StephS/6-Pack_CNC_Controller/images/iot_relay.png

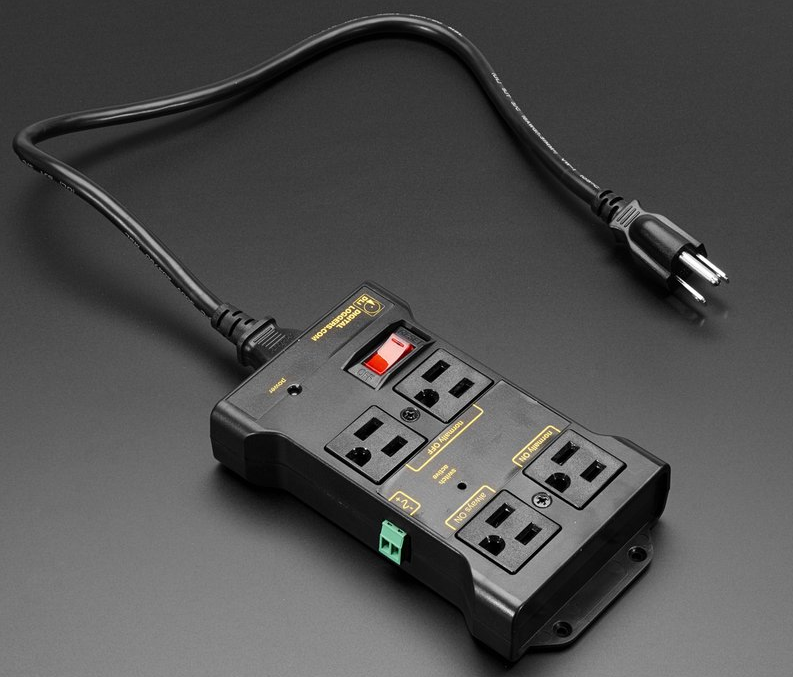
images/iot_relay.png
