StephS/6-Pack_CNC_Controller/versions/V1p8s/6_axis_I2S_v1p8s_Bottom.jpg

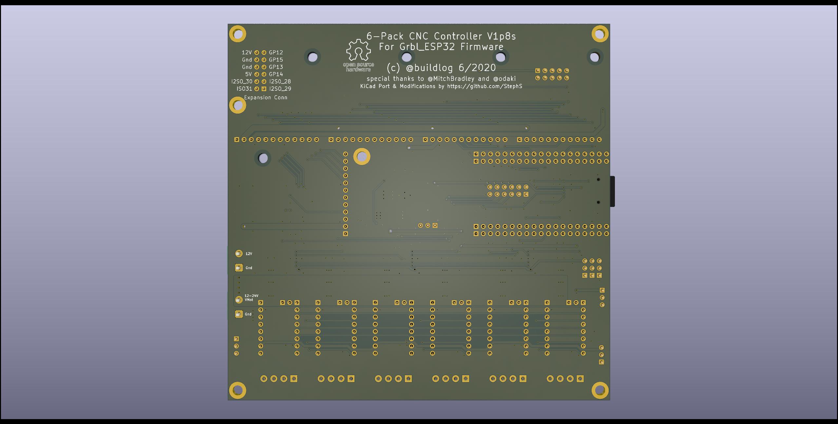
versions/V1p8s/6_axis_I2S_v1p8s_Bottom.jpg
