StephS/6-Pack_CNC_Controller/3D_Files/4x_support.stp

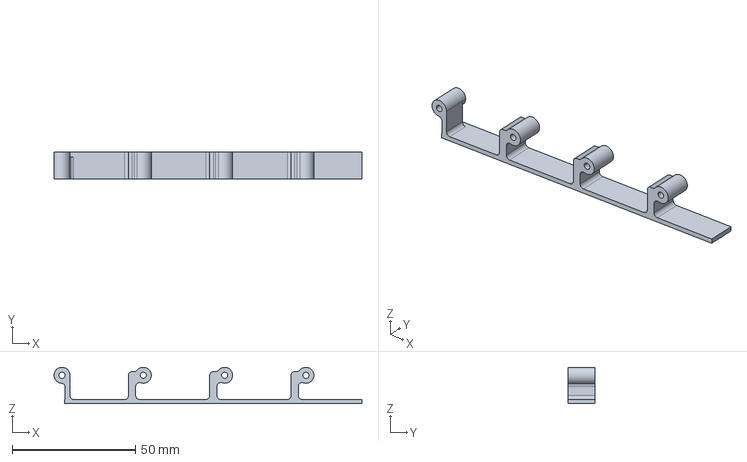
[picture p4: CAD file, 2022-01-27]
3D_Files/4x_support.stp
125.1 x 11.0 x 14.8 mm
