StephS/6-Pack_CNC_Controller/3D_Files/case/6_pack_cover_top.stp

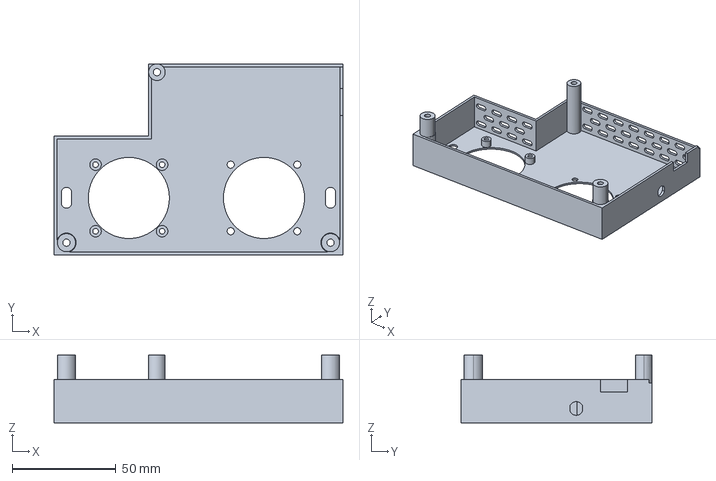
[picture p5: CAD file, 2022-01-27]
3D_Files/case/6_pack_cover_top.stp
139.0 x 92.0 x 32.7 mm
