StephS/6-Pack_CNC_Controller/3D_Files/1x_supp.stp

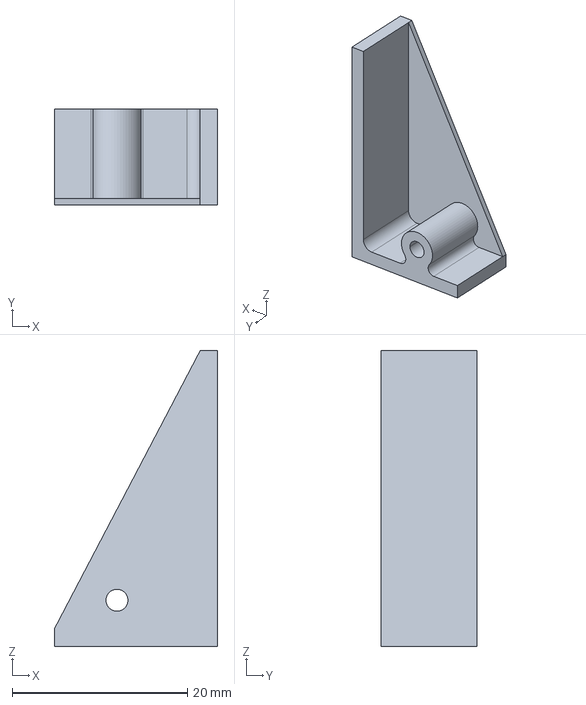
[picture p6: CAD file, 2022-01-27]
3D_Files/1x_supp.stp
18.7 x 11.0 x 33.8 mm
