StephS/6-Pack_CNC_Controller/3D_Files/case/6_pack_case_bottom.stp

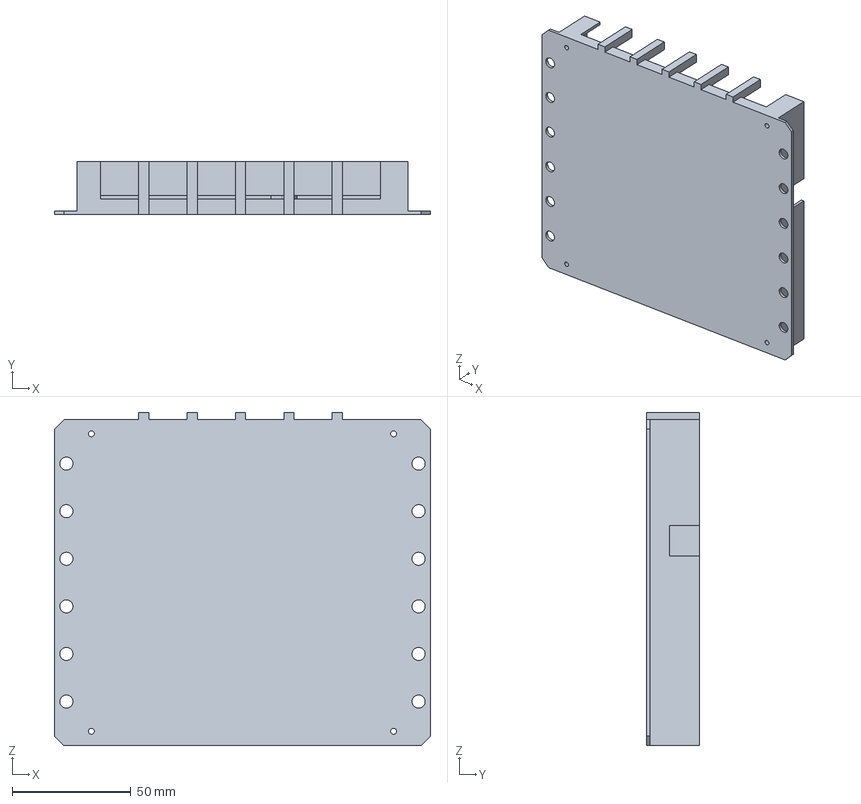
[picture p7: CAD file, 2022-01-27]
3D_Files/case/6_pack_case_bottom.stp
158.0 x 22.2 x 140.0 mm
