StephS/6-Pack_CNC_Controller/(list of files, cad)

Other CAD files:
3D_Files/1x_supp.stl
3D_Files/4x_support.stl
3D_Files/case/6_pack_case_bottom.stl
3D_Files/case/6_pack_cover_top.stl
