StephS/6-Pack_CNC_Controller/versions/V1p8s/6_axis_I2S_v1p8s.pdf

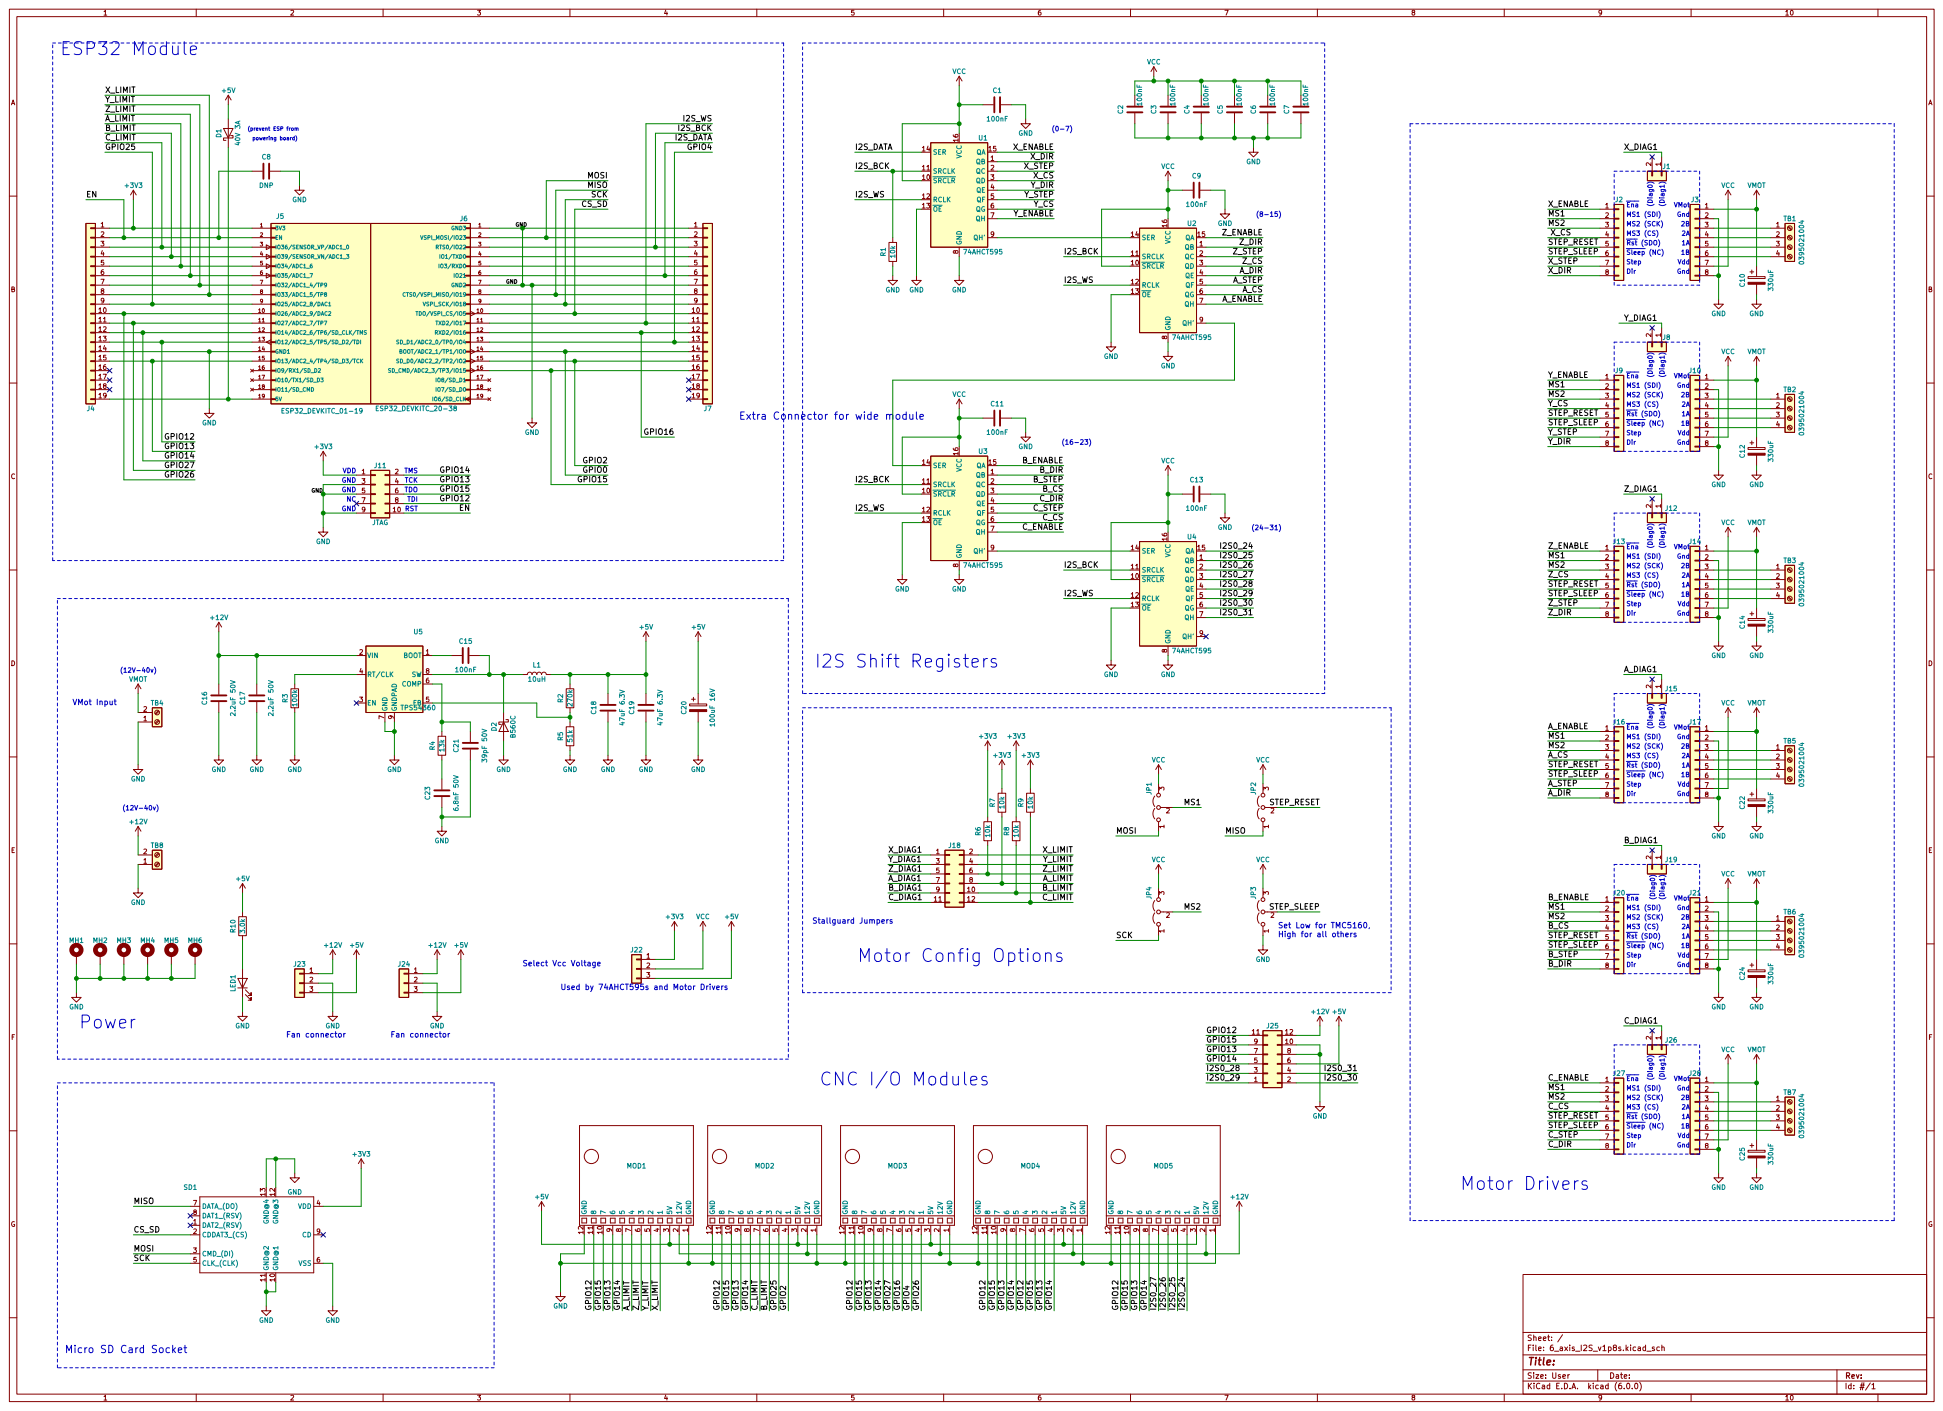
[picture p8: page 1]

Extra Connector for wide module

Micro SD Card Socket
