StephS/6-Pack_CNC_Controller/versions/V1p8s/6_axis_I2S_v1p8s.kicad_pcb

## KiCad design versions/V1p8s/6_axis_I2S_v1p8s.kicad_pcb (2021-12-27)

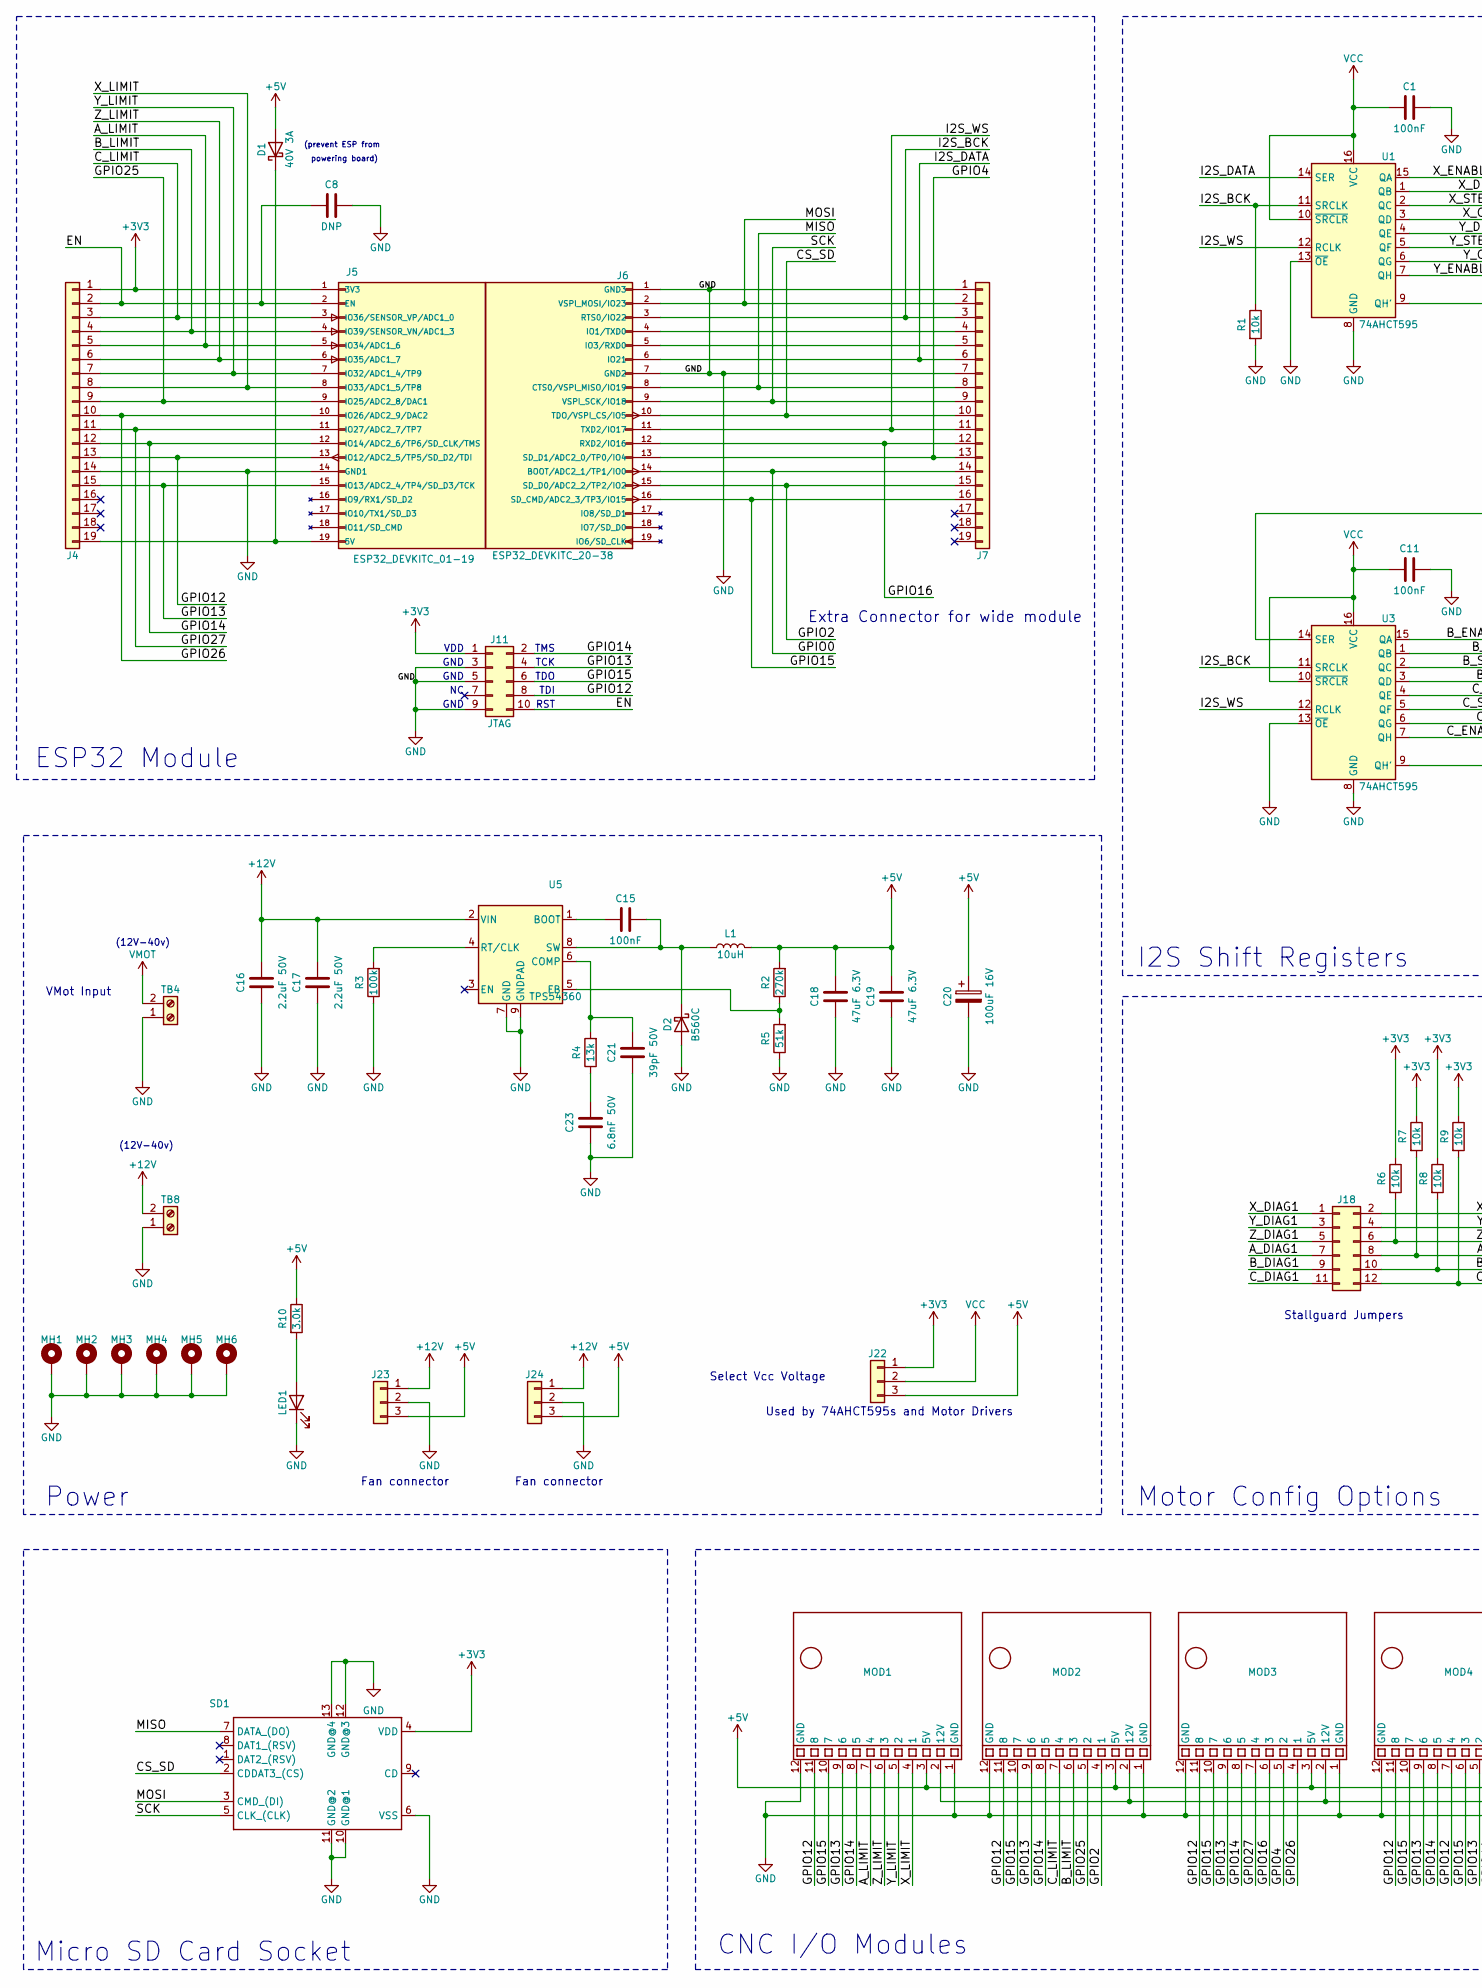
[picture p9: schematic 6_axis_I2S_v1p8s.kicad_sch, part in row 1, column 1]

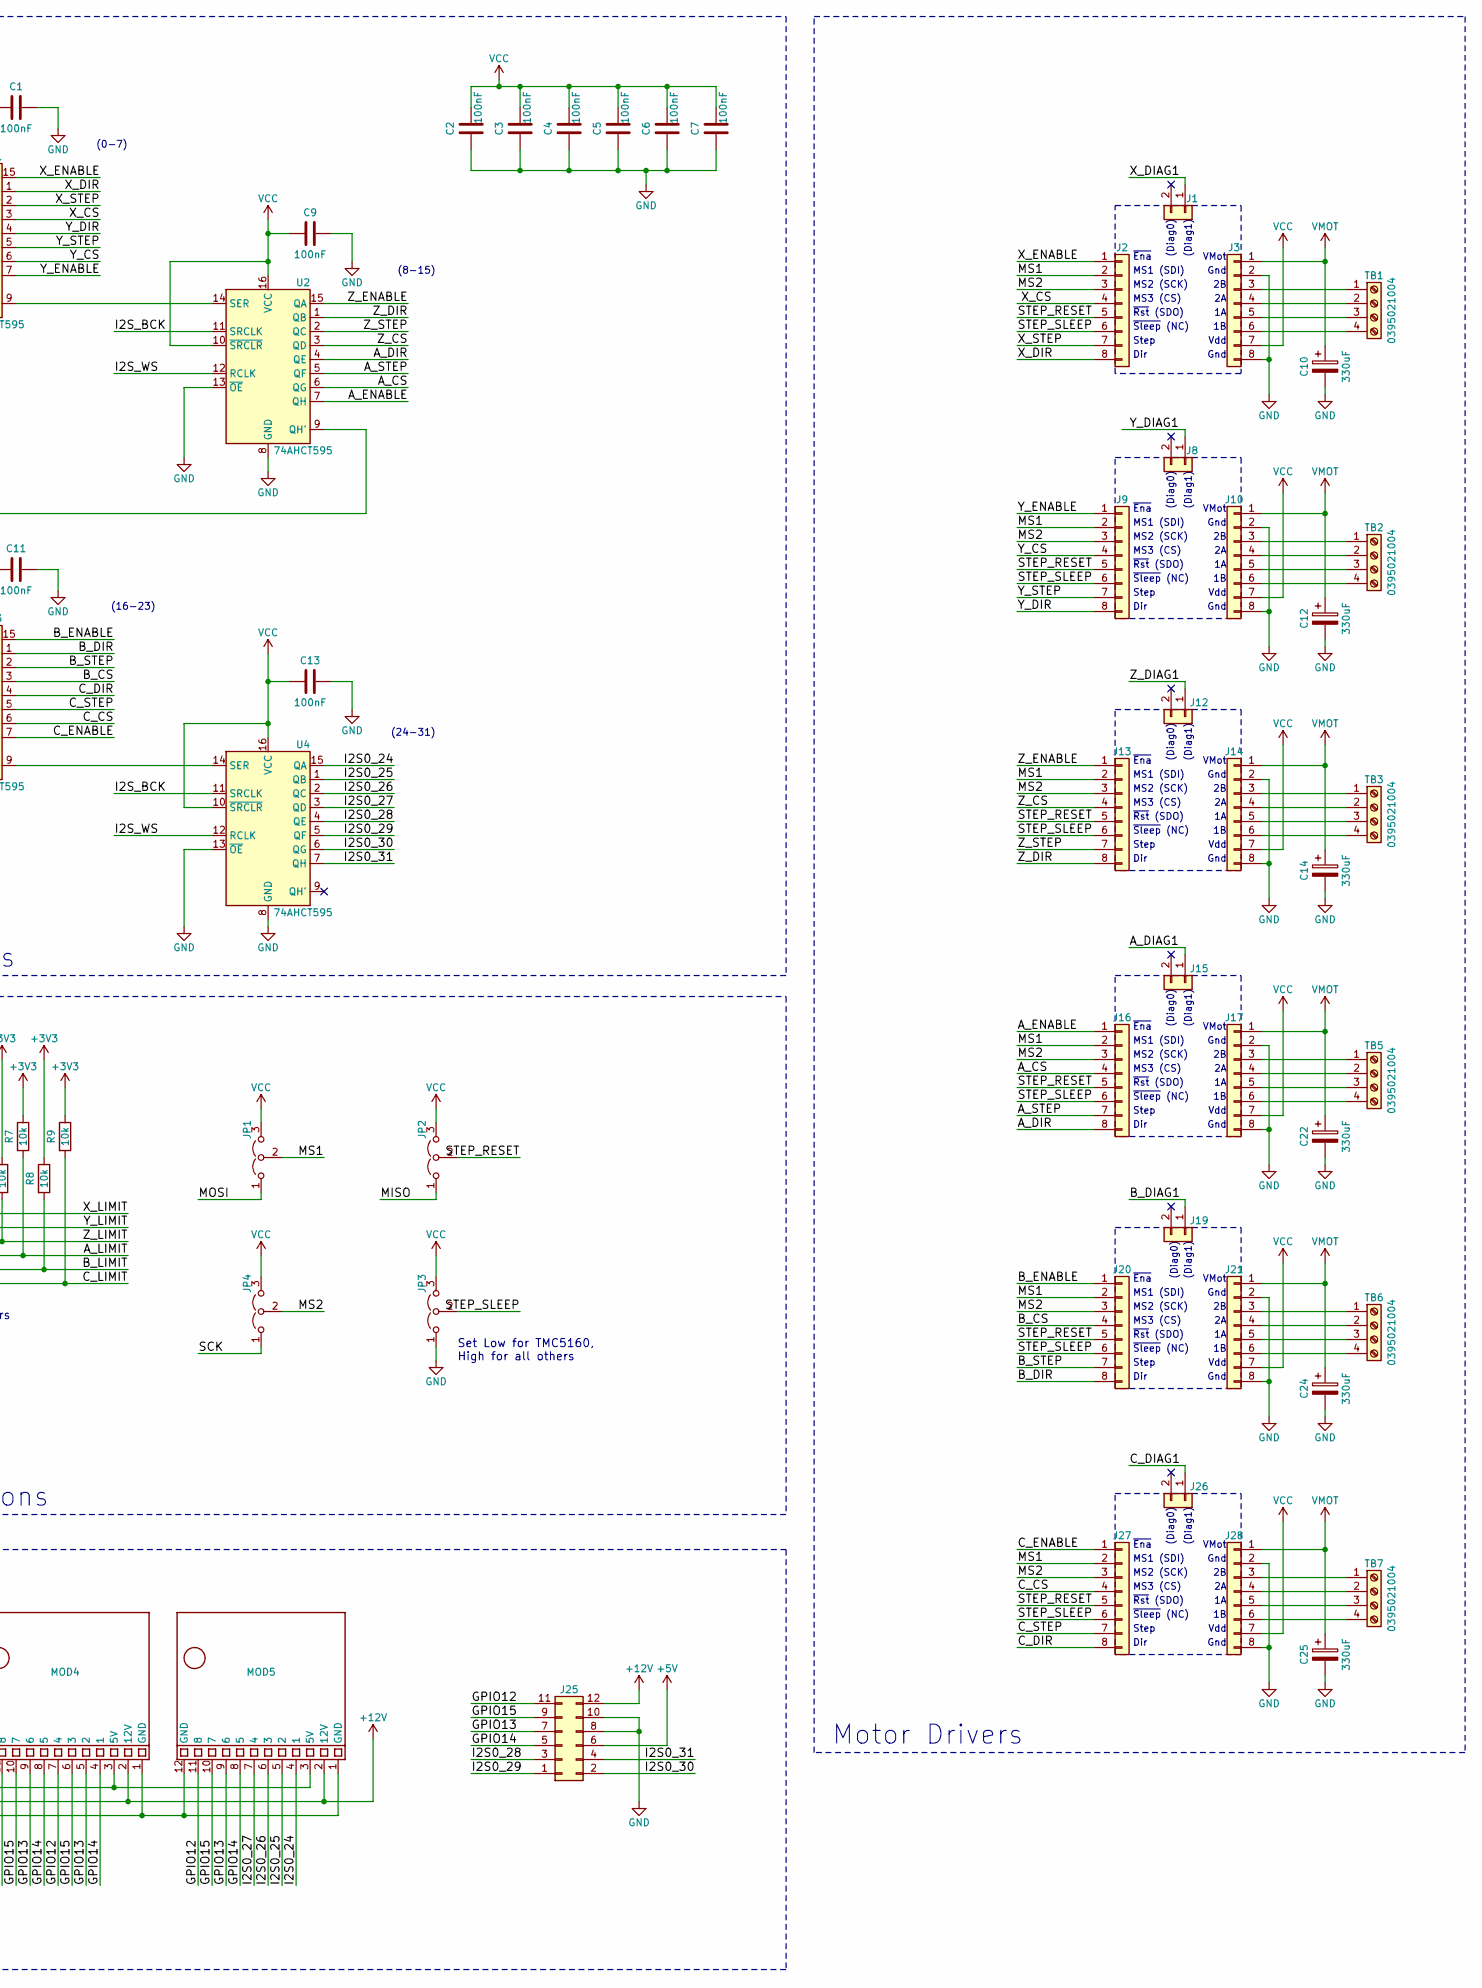
[picture p10: schematic 6_axis_I2S_v1p8s.kicad_sch, part in row 1, column 2]

Parts:
C1, C2, C3, C4, C5, C6, C7, C9, C11, C13, C15: 100nF; C_0402_1005Metric_Pad0.74x0.62mm_HandSolder
C8: DNP; C_1206_3216Metric_Pad1.42x1.75mm_HandSolder
C10, C12, C14, C22, C24, C25: 330uF; C_Elec_10x10.2
C16, C17: 2.2uF 50V; C_0805_2012Metric
C18, C19: 47uF 6.3V; C_0805_2012Metric
C20: 100uF 16V; CP_Elec_6.3x9.9
C21: 39pF 50V; C_0402_1005Metric
C23: 6.8nF 50V; C_0402_1005Metric
D1: 40V 3A; D_SMA
D2: B560C; D_SMC
J1, J8, J12, J15, J19, J26: 2 Pos; PinSocket_1x02_P2.54mm_Vertical
J2, J3, J9, J10, J13, J14, J16, J17, J20, J21, J27, J28: 8S; PinSocket_1x08_P2.54mm_Vertical
J4, J7: 19S; PinSocket_1x19_P2.54mm_Vertical
J5: ESP32_DEVKITC_01-19; PinSocket_1x19_P2.54mm_Vertical
J6: ESP32_DEVKITC_20-38; PinSocket_1x19_P2.54mm_Vertical
J11: JTAG; IDC-Header_2x05_P2.54mm_Vertical
J18: 6S; PinHeader_2x06_P2.54mm_Vertical
J22, J23, J24: 3P; PinHeader_1x03_P2.54mm_Vertical
J25: 6S; PinSocket_2x06_P2.54mm_Horizontal
JP1, JP2, JP3, JP4: 3P; PinHeader_1x03_P2.54mm_Vertical
L1: 10uH; L_Sunlord_MWSA0503_5.4x5.2mm; Part N MWSA0503S-100MT
LED1: GRN; LED_0805_2012Metric_Castellated
MH1, MH2, MH3, MH4, MH5, MH6: MOUNTING_HOLE_M3.7; MountingHole_3.5mm_Pad_TopBottom
MOD1, MOD2, MOD3, MOD4, MOD5: 1x12 Socket; CNC_ModuleSocket_1x12_P2.54mm
R1, R6, R7, R8, R9: 10k; R_0402_1005Metric
R2: 270k; R_0402_1005Metric
R3: 100k; R_0402_1005Metric
R4: 13k; R_0402_1005Metric
R5: 51k; R_0402_1005Metric
R10: 3.0k; R_0603_1608Metric_Pad0.98x0.95mm_HandSolder
SD1: Micro SD; HRO_ELEC-TF-01A
TB1, TB2, TB3, TB5, TB6, TB7: 0395021004; TerminalBlock_Molex_0395021004_1x04_P3.50mm_Horizontal
TB4, TB8: 2 Pos; TerminalBlock_Phoenix_MKDS-1,5-2_1x02_P5.00mm_Horizontal
U1, U2, U3, U4: 74AHCT595; SOIC-16_3.9x9.9mm_P1.27mm
U5: TPS54360; TI_SO-PowerPAD-8

Connections:
+3V3: J4.1, J5.1 (3V3), J11.1, J22.1, R6.1, R7.1, R8.1, R9.1, SD1.4 (VDD)
+5V: C18.2, C19.2, C20.1, D1.2 (A), J22.3, J23.3, J24.3, J25.6, L1.2, MOD1.3 (5V), MOD2.3 (5V), MOD3.3 (5V), MOD4.3 (5V), MOD5.3 (5V), R2.2, R10.1
+12V: C16.2, C17.2, J23.1, J24.1, J25.12, MOD1.2 (12V), MOD2.2 (12V), MOD3.2 (12V), MOD4.2 (12V), MOD5.2 (12V), TB8.2, U5.2 (VIN)
/A_CS: J16.4, U2.6 (QG)
/A_DIAG1: J15.1, J18.7
/A_DIR: J16.8, U2.4 (QE)
/A_ENABLE: J16.1, U2.7 (QH)
/A_LIMIT: J4.5, J5.5 (IO34/ADC1_6), J18.8, MOD1.7 (4), R7.2
/A_STEP: J16.7, U2.5 (QF)
/B_CS: J20.4, U3.3 (QD)
/B_DIAG1: J18.9, J19.1
/B_DIR: J20.8, U3.1 (QB)
/B_ENABLE: J20.1, U3.15 (QA)
/B_LIMIT: J4.4, J5.4 (IO39/SENSOR_VN/ADC1_3), J18.10, MOD2.6 (3), R8.2
/B_STEP: J20.7, U3.2 (QC)
/CS_SD: J6.10 (TDO/VSPI_CS/IO5), J7.10, SD1.2 (CDDAT3_(CS))
/C_CS: J27.4, U3.6 (QG)
/C_DIAG1: J18.11, J26.1
/C_DIR: J27.8, U3.4 (QE)
/C_ENABLE: J27.1, U3.7 (QH)
/C_LIMIT: J4.3, J5.3 (IO36/SENSOR_VP/ADC1_0), J18.12, MOD2.7 (4), R9.2
/C_STEP: J27.7, U3.5 (QF)
/EN: C8.1, J4.2, J5.2 (EN), J11.10
/GPIO0: J6.14 (BOOT/ADC2_1/TP1/IO0), J7.14
/GPIO2: J6.15 (SD_D0/ADC2_2/TP2/IO2), J7.15, MOD2.4 (1)
/GPIO4: J6.13 (SD_D1/ADC2_0/TP0/IO4), J7.13, MOD3.5 (2)
/GPIO12: J4.13, J5.13 (IO12/ADC2_5/TP5/SD_D2/TDI), J11.8, J25.11, MOD1.11 (8), MOD2.11 (8), MOD3.11 (8), MOD4.7 (4), MOD4.11 (8), MOD5.11 (8)
/GPIO13: J4.15, J5.15 (IO13/ADC2_4/TP4/SD_D3/TCK), J11.4, J25.7, MOD1.9 (6), MOD2.9 (6), MOD3.9 (6), MOD4.5 (2), MOD4.9 (6), MOD5.9 (6)
/GPIO14: J4.12, J5.12 (IO14/ADC2_6/TP6/SD_CLK/TMS), J11.2, J25.5, MOD1.8 (5), MOD2.8 (5), MOD3.8 (5), MOD4.4 (1), MOD4.8 (5), MOD5.8 (5)
/GPIO15: J6.16 (SD_CMD/ADC2_3/TP3/IO15), J7.16, J11.6, J25.9, MOD1.10 (7), MOD2.10 (7), MOD3.10 (7), MOD4.6 (3), MOD4.10 (7), MOD5.10 (7)
/GPIO16: J6.12 (RXD2/IO16), J7.12, MOD3.6 (3)
/GPIO25: J4.9, J5.9 (IO25/ADC2_8/DAC1), MOD2.5 (2)
/GPIO26: J4.10, J5.10 (IO26/ADC2_9/DAC2), MOD3.4 (1)
/GPIO27: J4.11, J5.11 (IO27/ADC2_7/TP7), MOD3.7 (4)
/I2S0_24: MOD5.4 (1), U4.15 (QA)
/I2S0_25: MOD5.5 (2), U4.1 (QB)
/I2S0_26: MOD5.6 (3), U4.2 (QC)
/I2S0_27: MOD5.7 (4), U4.3 (QD)
/I2S0_28: J25.3, U4.4 (QE)
/I2S0_29: J25.1, U4.5 (QF)
/I2S0_30: J25.2, U4.6 (QG)
/I2S0_31: J25.4, U4.7 (QH)
/I2S_BCK: J6.3 (RTS0/IO22), J7.3, R1.1, U1.11 (SRCLK), U2.11 (SRCLK), U3.11 (SRCLK), U4.11 (SRCLK)
/I2S_DATA: J6.6 (IO21), J7.6, U1.14 (SER)
/I2S_WS: J6.11 (TXD2/IO17), J7.11, U1.12 (RCLK), U2.12 (RCLK), U3.12 (RCLK), U4.12 (RCLK)
/MISO: J6.8 (CTS0/VSPI_MISO/IO19), J7.8, JP2.1 (A), SD1.7 (DATA_(DO))
/MOSI: J6.2 (VSPI_MOSI/IO23), J7.2, JP1.1 (A), SD1.3 (CMD_(DI))
/MS1: J2.2, J9.2, J13.2, J16.2, J20.2, J27.2, JP1.2 (C)
/MS2: J2.3, J9.3, J13.3, J16.3, J20.3, J27.3, JP4.2 (C)
/SCK: J6.9 (VSPI_SCK/IO18), J7.9, JP4.1 (A), SD1.5 (CLK_(CLK))
/STEP_RESET: J2.5, J9.5, J13.5, J16.5, J20.5, J27.5, JP2.2 (C)
/STEP_SLEEP: J2.6, J9.6, J13.6, J16.6, J20.6, J27.6, JP3.2 (C)
/X_CS: J2.4, U1.3 (QD)
/X_DIAG1: J1.1, J18.1
/X_DIR: J2.8, U1.1 (QB)
/X_ENABLE: J2.1, U1.15 (QA)
/X_LIMIT: J4.8, J5.8 (IO33/ADC1_5/TP8), J18.2, MOD1.4 (1)
/X_STEP: J2.7, U1.2 (QC)
/Y_CS: J9.4, U1.6 (QG)
/Y_DIAG1: J8.1, J18.3
/Y_DIR: J9.8, U1.4 (QE)
/Y_ENABLE: J9.1, U1.7 (QH)
/Y_LIMIT: J4.7, J5.7 (IO32/ADC1_4/TP9), J18.4, MOD1.5 (2)
/Y_STEP: J9.7, U1.5 (QF)
/Z_CS: J13.4, U2.3 (QD)
/Z_DIAG1: J12.1, J18.5
/Z_DIR: J13.8, U2.1 (QB)
/Z_ENABLE: J13.1, U2.15 (QA)
/Z_LIMIT: J4.6, J5.6 (IO35/ADC1_7), J18.6, MOD1.6 (3), R6.2
/Z_STEP: J13.7, U2.2 (QC)
GND: C1.2, C2.1, C3.1, C4.1, C5.1, C6.1, C7.1, C8.2, C9.2, C10.2, C11.2, C12.2, C13.2, C14.2, C16.1, C17.1, C18.1, C19.1, C20.2, C21.1, C22.2, C23.1, C24.2, C25.2, D2.2 (A), J3.2, J3.8, J4.14, J5.14 (GND1), J6.1 (GND3), J6.7 (GND2), J7.1, J7.7, J10.2, J10.8, J11.3, J11.5, J11.9, J14.2, J14.8, J17.2, J17.8, J21.2, J21.8, J23.2, J24.2, J25.8, J25.10, J28.2, J28.8, JP3.1 (A), LED1.1 (K), MH1.1, MH2.1, MH3.1, MH4.1, MH5.1, MH6.1, MOD1.1 (GND), MOD1.12 (GND), MOD2.1 (GND), MOD2.12 (GND), MOD3.1 (GND), MOD3.12 (GND), MOD4.1 (GND), MOD4.12 (GND), MOD5.1 (GND), MOD5.12 (GND), R1.2, R3.1, R5.1, SD1.6 (VSS), SD1.10 (GND@1), SD1.11 (GND@2), SD1.12 (GND@3), SD1.13 (GND@4), TB4.1, TB8.1, U1.8 (GND), U1.13 (~OE), U2.8 (GND), U2.13 (~OE), U3.8 (GND), U3.13 (~OE), U4.8 (GND), U4.13 (~OE), U5.7 (GND), U5.9 (GNDPAD)
unnamed: C15.1, U5.1 (BOOT)
unnamed: C15.2, D2.1 (K), L1.1, U5.8 (SW)
unnamed: C21.2, R4.2, U5.6 (COMP)
unnamed: C23.2, R4.1
unnamed: D1.1 (K), J4.19, J5.19 (5V)
unnamed: J3.3, TB1.1
unnamed: J3.4, TB1.2
unnamed: J3.5, TB1.3
unnamed: J3.6, TB1.4
unnamed: J6.4 (IO1/TXD0), J7.4
unnamed: J6.5 (IO3/RXD0), J7.5
unnamed: J10.3, TB2.1
unnamed: J10.4, TB2.2
unnamed: J10.5, TB2.3
unnamed: J10.6, TB2.4
unnamed: J14.3, TB3.1
unnamed: J14.4, TB3.2
unnamed: J14.5, TB3.3
unnamed: J14.6, TB3.4
unnamed: J17.3, TB5.1
unnamed: J17.4, TB5.2
unnamed: J17.5, TB5.3
unnamed: J17.6, TB5.4
unnamed: J21.3, TB6.1
unnamed: J21.4, TB6.2
unnamed: J21.5, TB6.3
unnamed: J21.6, TB6.4
unnamed: J28.3, TB7.1
unnamed: J28.4, TB7.2
unnamed: J28.5, TB7.3
unnamed: J28.6, TB7.4
unnamed: LED1.2 (A), R10.2
unnamed: R2.1, R5.2, U5.5 (FB)
unnamed: R3.2, U5.4 (RT/CLK)
unnamed: U1.9 (QH'), U2.14 (SER)
unnamed: U2.9 (QH'), U3.14 (SER)
unnamed: U3.9 (QH'), U4.14 (SER)
VCC: C1.1, C2.2, C3.2, C4.2, C5.2, C6.2, C7.2, C9.1, C11.1, C13.1, J3.7, J10.7, J14.7, J17.7, J21.7, J22.2, J28.7, JP1.3 (B), JP2.3 (B), JP3.3 (B), JP4.3 (B), U1.10 (~SRCLR), U1.16 (VCC), U2.10 (~SRCLR), U2.16 (VCC), U3.10 (~SRCLR), U3.16 (VCC), U4.10 (~SRCLR), U4.16 (VCC)
VMOT: C10.1, C12.1, C14.1, C22.1, C24.1, C25.1, J3.1, J10.1, J14.1, J17.1, J21.1, J28.1, TB4.2

Notes on the sheet:
Stallguard Jumpers
VMot
MS3 (CS)
TDO
~{Sleep} (NC)
MS1 (SDI)
(12V-40v)
MS2 (SCK)
~{Ena}
GND
~{Rst} (SDO)
Dir
Step
Gnd
(Diag0)
(Diag1)
(prevent ESP from
TMS
Vdd
Extra Connector for wide module
ESP32 Module
(16-23)
Select Vcc Voltage
(0-7)
Power
RST
Micro SD Card Socket
Used by 74AHCT595s and Motor Drivers
powering board)
I2S Shift Registers
(8-15)
TCK
Fan connector
Motor Drivers
(24-31)
TDI
Motor Config Options
VDD
Set Low for TMC5160, High for all others
CNC I/O Modules
VMot Input

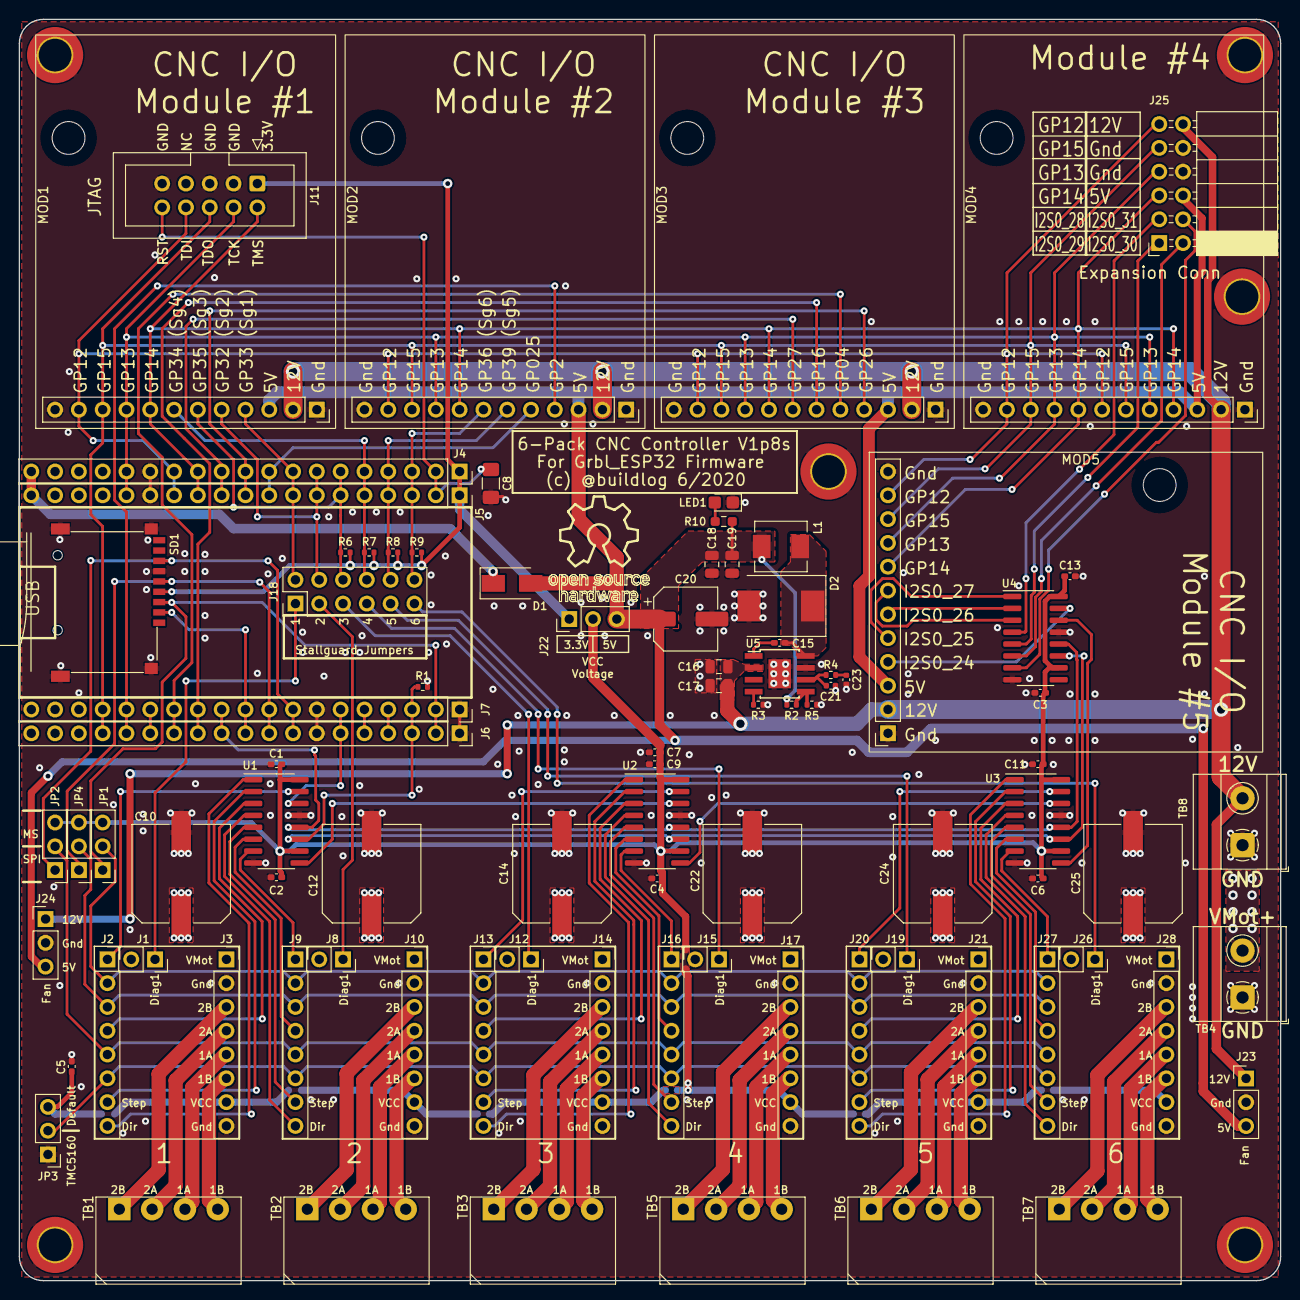
[picture p11: board 6_axis_I2S_v1p8s.kicad_pcb from above]

Board: 2 copper layers, 134.6 x 134.6 mm, 96 parts (0 on the bottom side), 110 nets.
