StephS/6-Pack_CNC_Controller/machine_defs/spi_daisy_4axis_xyza.h

#pragma once
// clang-format off

/*
    spi_daisy_4axis_xyza.h
    Part of Grbl_ESP32

    Pin assignments for a 4-axis machine using Triaminic drivers
    in daisy-chained SPI mode.
    https://github.com/bdring/4_Axis_SPI_CNC

    2019    - Bart Dring
    2020    - Mitch Bradley

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
    You should have received a copy of the GNU General Public License
    along with Grbl_ESP32.  If not, see <http://www.gnu.org/licenses/>.
*/

#define MACHINE_NAME "SPI_DAISY_4X XYZA"

#ifdef N_AXIS
        #undef N_AXIS
#endif
#define N_AXIS 4 // can be 3 or 4. (if 3 install bypass jumper next to the A driver)

#define TRINAMIC_DAISY_CHAIN

#define TRINAMIC_RUN_MODE           TrinamicMode::StealthChop

// Use SPI enable instead of the enable pin
// The hardware enable pin is tied to ground
#define USE_TRINAMIC_ENABLE

#define X_TRINAMIC_DRIVER       2130        // Which Driver Type?
#define X_RSENSE                TMC2130_RSENSE_DEFAULT
#define X_STEP_PIN              GPIO_NUM_12
#define X_DIRECTION_PIN         GPIO_NUM_14
#define X_CS_PIN                GPIO_NUM_17  // Daisy Chain, all share same CS pin

#define Y_TRINAMIC_DRIVER       2130        // Which Driver Type?
#define Y_RSENSE                TMC2130_RSENSE_DEFAULT
#define Y_STEP_PIN              GPIO_NUM_27
#define Y_DIRECTION_PIN         GPIO_NUM_26
#define Y_CS_PIN                X_CS_PIN  // Daisy Chain, all share same CS pin

#define Z_TRINAMIC_DRIVER       2130        // Which Driver Type?
#define Z_RSENSE                TMC2130_RSENSE_DEFAULT
#define Z_STEP_PIN              GPIO_NUM_15
#define Z_DIRECTION_PIN         GPIO_NUM_2
#define Z_CS_PIN                X_CS_PIN  // Daisy Chain, all share same CS pin


#define A_TRINAMIC_DRIVER       2130        // Which Driver Type?
#define A_RSENSE                TMC2130_RSENSE_DEFAULT
#define A_STEP_PIN              GPIO_NUM_33
#define A_DIRECTION_PIN         GPIO_NUM_32
#define A_CS_PIN                X_CS_PIN  // Daisy Chain, all share same CS pin

// Mist is a 3.3V output
// Turn on with M7 and off with M9
#define COOLANT_MIST_PIN        GPIO_NUM_21

#define SPINDLE_OUTPUT_PIN      GPIO_NUM_25
#define SPINDLE_ENABLE_PIN      GPIO_NUM_4

#define SPINDLE_TYPE            SpindleType::RELAY // default use $Spindle/Type=PWM or $Spindle/Type=Laser

#define PROBE_PIN               GPIO_NUM_22
