StephS/6-Pack_CNC_Controller/(commit log)

2021-05-27 Port to Kicad - v1p8s
    Initial port to KiCad, board is yet untested. Passes DRC and ERC.
    a 2nd power plug has been added, TB8, that supplies the 5V regulator, fan headers, and all of the CNC Modules.
    some minor connector location changes.
    Lots of trace layout changes.
    [6_axis_I2S_v1p8s.kicad_pcb, 6_axis_I2S_v1p8s.kicad_sch]
2021-10-31 layout changes, screw hole placement changes, generate gerbers
    [6_axis_I2S_v1p8s-B_Cu.gbr, 6_axis_I2S_v1p8s-B_Mask.gbr, 6_axis_I2S_v1p8s-B_Paste.gbr, 6_axis_I2S_v1p8s-B_Silkscreen.gbr, 6_axis_I2S_v1p8s-Edge_Cuts.gbr, 6_axis_I2S_v1p8s-F_Cu.gbr, 6_axis_I2S_v1p8s-F_Mask.gbr, 6_axis_I2S_v1p8s-F_Paste.gbr]
2021-12-27 Update to Kicad 6.0 and add Schematic PDF
    [6_axis_I2S_v1p8s.kicad_pcb, 6_axis_I2S_v1p8s.kicad_sch]
2021-12-27 Add Interactive BOM and fix worksheet error
    [6_axis_I2S_v1p8s.kicad_pcb, 6_axis_I2S_v1p8s.kicad_sch]
